chichunwang/self_balance_plane/plan-a-handoff/參考文件/2026-10-27-測試紀錄與監控-design.md

# 測試紀錄與監控：設計

> **狀態：使用者 2026-10-27 同意；第一批（相機）已寫，第二批（伺服、IMU、調平）等樹莓派接好**
> 搭配 [`docs/硬體上機檢查清單.md`](硬體上機檢查清單.md)。清單是給人照著做的；這份寫「每次測試留下什麼、格式、時間怎麼對、怎麼回到筆電、要寫哪些工具」，給寫工具和寫控制程式的人看。

## 1. 為什麼要做

使用者原話（2026-10-27）：「我想要測試要有log 甚至測試相機也會錄影 這樣你就有所有測試data等同於一個回授去調整你的程式」。

所以目標是一個迴圈：實機測試 → 紀錄自動回到筆電 → 我看圖、算成績、把真實資料餵回模擬 → 改參數或程式 → 再上機。

- **要做到**
  - 每次測試（包括校正工具）自動留一個完整的資料夾，不靠人記得按錄影。
  - 相機每一張、每個控制週期、IMU、壓電片、使用者按鍵，全部在同一個時鐘上，事後對得起來。
  - 紀錄能直接餵進 `ppsim` 的估測器和控制器重播。
- **不做**：雲端、資料庫、漂亮的儀表板（第一版只有終端機一行狀態）、把全解析度影像即時傳回筆電。
- **絕對不能**：記錄或監看讓控制迴圈晚拍（比沒有紀錄還糟）；錄影加疊圖或壓太爛，事後沒辦法重新找球。

## 2. 決定

使用者決定的：
1. 控制用樹莓派 4（4GB）優先（2026-10-27：「teensy這個先不做 還是以rpi4 4gb優先」）。之後在 Teensy 那個對話同意 README、BOM 兩套都寫完整、檔頭註明樹莓派優先；這份設計照樹莓派寫，換 Teensy 時時鐘那節要改（要跟 Teensy 對時）。
2. 測試資料用 SSH 從筆電拉回（2026-10-27：「可以」）。
3. 其他都照我的建議（2026-10-27：「都照建議 你跟我說怎麼做就行」）。下面這些是**我的預設**，使用者看到不對可以推翻：

| # | 預設 | 理由 |
|---|---|---|
| a | 伺服訊號用 PCA9685（BOM 方案 B），I²C 跟 IMU 共用，400 kHz | 波形由硬體產生，不受 Linux 排程影響；樹莓派自己的硬體 PWM 只有兩路 |
| b | 正面＝1 號伺服那側（+y） | BOM 第 0 節第 8 點本來就這樣定；盪鞦韆相機架的腳在左右 |
| c | 樹莓派存 `~/pp/runs/`，筆電存專案的 `out/real/` | 輸出留在專案裡；C 槽還有約 64 GB，替代相機每分鐘約 50–80 MB（要實測） |
| d | 錄影每一張都存、灰階 JPEG 一張接一張存成一個檔、不疊圖 | 程式當掉也不會壞檔；事後可以重新找球；疊圖影片在筆電上另外做 |
| e | 監看第一版：SSH 終端機每 0.5 秒一行狀態＋跑完印摘要；即時視窗等第一輪實測後再決定要不要做 | 樹莓派 4 的 CPU 留給控制和找球 |
| f | 手機側拍是選配，用 GPIO27 的 LED 對時 | LED 同時拍得進俯視相機和手機，順便量相機延遲 |
| g | IMU 零點用手機水平儀「原地轉 180°」量平台的真實傾斜當基準 | 理由在清單第 6 階段開頭 |
| h | 程式放新的頂層資料夾 `ppreal/`（跟 `ppsim/` 並列），樹莓派的 `~/pp/` 是同一份的副本 | 實機的東西集中一處，模擬那邊不動 |

## 3. 時鐘

- **樹莓派上全部用 `CLOCK_MONOTONIC`**，Python 裡就是 `time.monotonic_ns()`。下面兩個也是這個時鐘（2026-10-27 查原始碼確認），所以**不用對時**，直接比：
  - 相機：OpenCV 要明講用 V4L2 後端（`cv2.VideoCapture(0, cv2.CAP_V4L2)`），`CAP_PROP_POS_MSEC` 就是 V4L2 buffer 的時間戳。uvcvideo 預設在「主機收到這一張的第一個 USB 封包」時打點，**不是曝光的時刻**；曝光到打點差多少要用 LED 量（清單 7-8）。
  - 壓電片：Trixie 的 `python3-libgpiod` 是 v2，`EdgeEvent.timestamp_ns` 預設是 MONOTONIC。**不要設 `debounce_period`**：設了以後時間戳會晚一整段去彈跳時間；連跳在程式裡照時間戳濾掉。
  - IMU 沒有自己的時間戳，記讀完當下的 `monotonic_ns()`。
- 筆電上（明天先用筆電測替代相機）用 `time.perf_counter_ns()`；Windows 的 DSHOW 不給每張的時間戳，只記「讀到的時刻」。
- 每一列都記整數 `t_ns`（絕對值）。`meta.json` 記這次的 `t0_ns` 和開始的牆上時間，分析時換成「開始後幾秒」。
- 跟手機側拍對時：開始和結束時 LED 閃 3 下（短短長），事件檔記每一下的時間；俯視相機的畫面裡也拍得到 LED，順便量相機延遲。

## 4. 一次測試＝一個資料夾

名稱 `<流水號>_YYYYMMDD-HHMMSS_<種類>`，例如 `0007_20261028-153012_balance`。樹莓派 4 沒有電池時鐘，比賽現場沒網路時牆上時間可能不對，排序和認資料夾靠流水號（存在 `~/pp/runs/.seq`）；`pp run` 開跑前如果連得到筆電，就順便把時間對過去。
種類：`balance`、`push`、`servo`、`imu`、`level`、`cam`、`motion`……校正工具跑的時候也開資料夾。

| 檔案 | 誰寫 | 多久一筆 | 格式 |
|---|---|---|---|
| `meta.json` | 啟動程式 | 開始、結束各寫一次 | JSON |
| `events_<程式>.csv` | 各程式各寫一個（`launcher`／`ctrl`／`vision`） | 有事才寫 | CSV，拉回時照 `t_ns` 合併成 `events.csv` |
| `control.bin` | 啟動程式（資料來自控制程式） | 每個控制週期 | 二進位（numpy 結構陣列，欄位寫在 meta） |
| `imu.bin` | 啟動程式（資料來自控制程式） | 每讀一次 IMU | 二進位 |
| `camera.csv` | 找球程式的錄影執行緒 | 每一張 | CSV |
| `cam.mjpeg` | 找球程式的錄影執行緒 | 每一張 | JPEG 一張接一張 |
| `piezo.csv` | 啟動程式（資料來自控制程式） | 每次觸發（期末） | CSV |
| `system.csv` | 啟動程式 | 每秒 | CSV |
| `console.log` | 啟動程式 | — | 終端機印出的全部文字 |

**控制程式完全不碰檔案。** 每拍把一列寫進共享記憶體的環形緩衝（筆電實測填一列 2–4 µs，樹莓派 4 估計 10–20 µs，不到一拍的 1%），由啟動程式（它本來就要讀共享記憶體印狀態行）每 0.2 秒收一次、寫檔。理由：
- 寫檔平常只要幾十 µs，但 ext4 提交日誌、或同一張記憶卡上錄影寫太多被節流時，會卡幾十到幾百 ms，控制迴圈不能等。
- 也不能在控制程式裡開執行緒排版 CSV：Python 的 GIL 每 5 ms 才換手，會讓控制迴圈晚拍（README「硬體接法」在筆電上實測過）。
- 找球程式的錄影執行緒寫檔沒關係：寫檔時會放開 GIL，卡住的只有那條執行緒，主執行緒照樣讀相機、找球；來不及就跳過那張不存。

當掉或斷電掉多少：控制程式當掉只掉環形緩衝裡還沒收的（≤ 0.2 秒）；啟動程式每 5 秒 `fsync` 一次，樹莓派突然斷電最多掉最後 5 秒（不 fsync 的話 Linux 預設約 30 秒才寫回記憶卡）。二進位轉 CSV 時，檔尾不滿一列的半截丟掉。

### 4.1 `meta.json`
- `run_id`、`kind`、`note`（開始時打的備註）、`result`（跑完問「結果？」打的那句）、`status`（`running`／`done`／`crashed`：開始就寫 `running`，正常結束才改）
- `wall_start`、`wall_end`、`t0_ns`、`t_end_ns`、`clock`（`CLOCK_MONOTONIC` 或 `perf_counter`）、`host`
- `code`：`ppsim/`、`ppreal/` 每個 `.py` 的雜湊和合起來的短碼（專案不是 git，用這個認版本）
- `params`：這次用的 `ppsim.params.Config` 全部值（含改過的）
- `calib`：當時 `calib.json` 的完整內容
- `camera`：要求的和讀回的設定（寬高、格式、曝光）、實際每秒張數
- `dtypes`：`control.bin`、`imu.bin` 的欄位和型別；`mode_codes`：模式代碼對照
- `summary`：結束時算的成績（見第 6 節的摘要）
- `versions`：Python、numpy、OpenCV 版本

### 4.2 `control.bin`（每個控制週期一列，約 104 bytes）
| 欄位 | 型別 | 說明 |
|---|---|---|
| `t_ns` | int64 | 這一拍開始的時刻 |
| `tick` | uint32 | 第幾拍 |
| `dt_us` | float32 | 跟上一拍開始差多久（看有沒有晚拍） |
| `busy_us` | float32 | 這一拍算了多久 |
| `mode` | uint8 | 控制器模式（代碼寫在 meta） |
| `est_ok` | uint8 | 估測器有沒有鎖定球 |
| `meas_age_ms` | float32 | 用到的最新一張相機量測離拍攝多久 |
| `est_x/y/z` | float32×3 | 估測的球位置（mm，平台座標） |
| `est_vx/vy/vz` | float32×3 | 估測的球速度（mm/s） |
| `tau_x/y` | float32×2 | 控制器要的傾斜（`ppsim` 的定義：指向下坡、tan 值） |
| `heave_mm` | float32 | 要的升降 |
| `trim_x/y` | float32×2 | 自動水平校正目前的修正量 |
| `th1/2/3` | float32×3 | 三顆伺服角命令（度，臂往上＝正） |
| `us1/2/3` | float32×3 | 實際送出的脈寬（µs） |
| `imu_fb/lr` | float32×2 | 最新 IMU 傾斜（度，前面高／右邊高為正；這拍沒讀就 NaN） |
| `flags` | uint16 | 晚拍、球不見、I²C 錯誤等旗標 |

### 4.3 `camera.csv`（每張一列）
`frame`、`t_cap_ns`（V4L2 時間戳；筆電上空白）、`t_read_ns`（讀到的時刻）、`t_done_ns`（找完球的時刻）、`found`、`u_px`、`v_px`、`r_px`（球心和半徑）、`x_mm`、`y_mm`（換到平台座標）、`area_px`、`rec`（有沒有存進影片；錄影來不及時會跳過，記 0）、`jpg_off`、`jpg_len`（這張在 `cam.mjpeg` 的位置）。

### 4.4 `imu.bin`
`t_ns`、`ax`、`ay`、`az`、`temp`、`gx`、`gy`、`gz`（MPU-6050 原始 int16，之後換校正值可以重算）、`err`（這次讀取有沒有 I²C 錯誤）。

### 4.5 `events_<程式>.csv`（拉回後合併成 `events.csv`）
`t_ns`、`src`（`ctrl`／`vision`／`launcher`／`tool`）、`kind`、`detail`。控制程式的事件也是放進共享記憶體、由啟動程式寫。
`kind`：`start`、`stop`、`mark`（使用者按空白鍵＝「我推了」；按 `m` 可以打一句話）、`mode`（模式切換）、`warn`、`error`、`led`、`calib`（校正工具改了哪個值，從多少改成多少）。

### 4.6 `system.csv`（每秒一列）
`t_ns`、`cpu_temp_c`、`throttled`（`vcgencmd get_throttled` 的值）、`arm_mhz`、`load1`、`ctrl_cpu_pct`、`vision_cpu_pct`、`mem_avail_mb`、`disk_free_mb`、`log_dropped`（排不進佇列丟掉幾筆）。

## 5. 錄影

- 找球程式讀到的每一張都存：主執行緒讀相機、找球、把結果交給控制程式；另一條執行緒做 JPEG 壓縮和寫檔（OpenCV 的壓縮會放開 GIL）。佇列滿了就跳過那張不存（`rec`＝0、計數），**絕不讓找球等錄影**。
- 替代相機給 YUYV：`CAP_PROP_CONVERT_RGB` 設 false，OpenCV 回傳 480×640×2 的原始 YUYV，第 0 層就是灰階（不用轉彩色），JPEG 品質 90。OV9281 本來就給 MJPEG：同樣設定下 OpenCV 回傳 1×N 的 JPEG 位元組（查過 `cap_v4l.cpp`），直接存、不重壓，找球時再 `cv2.imdecode`。
- `cam.mjpeg` 就是 JPEG 一張接一張，當掉也不會整檔壞掉；`camera.csv` 有每張的位置。
- 不疊圖。筆電上 `pp report` 另外做 `overlay.mp4`：畫上找到的球（圈）、估測位置（點）、平台傾斜（箭頭）、時間和模式。
- 大小（要實測）：替代相機灰階 640×480 每張約 25–45 KB，每分鐘約 50–80 MB。OV9281 每秒 120 張時：640×480 約大 4 倍、1280×720 約大 12 倍，到時候再看要不要降存檔張數或改存 D 槽。
- `.mjpeg` 用 VLC 或 ffplay 播得出來，Windows 內建播放器不行；平常看 `pp report` 轉出的 mp4。

## 6. 即時監看

第一版（樹莓派 4 的 CPU 留給控制和找球）：

- 使用者在筆電的 PowerShell 用 SSH 開 `pp run ...`，終端機每 0.5 秒更新一行：
  ```
  12.4s 平衡  球(+3.1,-0.8)mm  傾斜 前+0.4° 右-0.1°  迴圈 p99 2.1ms 晚0  相機 30.0/s 掉0  62°C
  ```
- 按鍵：空白鍵＝記「我推了」、`m`＝打一句備註、`q`＝停。
- 每次按空白鍵（推球）後，狀態行下面多印一行：這次推完球的最大速度（cm/s）、滾最遠離中心多遠、幾秒回到 1 cm 內。使用者才知道自己推多大力（清單第 9 階段有模擬給的期待值）。
- 跑完馬上印摘要：撐了幾秒、有沒有掉、穩住後球離中心的 RMS 和最遠、每次推的速度和回來的秒數、迴圈最慢幾 ms、晚了幾拍、相機掉幾張、最高溫度；然後問「結果？」。
- 這一行和摘要由**啟動程式**印（另一個程式），控制程式只是每拍把幾個數字寫進共享記憶體，不印東西。
- 第一次連上時確認中文在 PowerShell 不是亂碼；是的話狀態行改用英文縮寫（`--ascii`）。
- 斷線和停止：
  - `pp run` 包在 `tmux` 裡跑，Wi-Fi 斷了 SSH 掉線也不會被砍；啟動程式也不理 SIGHUP。
  - 按 `q`：平台 1 秒內慢慢回中位、停住，再收尾寫檔。
  - 控制程式當掉：PCA9685 會一直送最後一個脈寬（平台停在最後的姿勢）。啟動程式發現它死了，就自己接手 I²C，1 秒內慢慢回中位。

第二版（第一輪實測後再決定）：啟動程式用 UDP 把狀態（每秒 20 次）和縮小的畫面（每秒 5 張、320×240）丟給筆電，筆電開一個視窗看球、軌跡、曲線。UDP 送不出去就丟掉，不會卡樹莓派。

## 7. 傳回筆電、存放、清理

- `pp pull`（筆電）：SSH 列出 `~/pp/runs/`，把還沒拉過的資料夾拉到 `out/real/`（Windows 內建的 `scp`，或 `ssh … tar | tar`），二進位轉 CSV，檢查張數和大小對得上，再在樹莓派那份放一個 `.pulled` 記號。測完我自己跑，不用使用者動手。
- `pp deploy`（筆電）：把 `ppsim/`、`ppreal/` 複製到樹莓派的 `~/pp/`，記下程式版本短碼。
- 樹莓派上**不自動刪**。記憶卡剩不到 4 GB 時 `pp preflight` 會警告、不到 1 GB 不讓跑；要清就跑 `pp clean`，只刪已經拉回筆電的，而且先問使用者。
- 筆電上全部留著。`out/real/` 超過 20 GB 時跟使用者說。

## 8. 分析（筆電，我用）

- `pp report <run>`：時間曲線（球位置、傾斜命令對 IMU 量到的、三顆脈寬、迴圈時間、相機間隔）、俯視軌跡、成績、`overlay.mp4`、`summary.md`。
- `pp replay <run>`：把紀錄裡的相機量測（和壓電片時間）照原本的時間餵進 `ppsim` 的 Estimator＋Controller，先確認重播出來的命令跟實機一樣；再改參數（例如 `--set control.bal_wn=2.5`）看會怎樣。
- 之後再做：跟模擬並排（同樣的起點、同樣的推球時刻）、從實測反推參數（相機延遲、伺服反應、球滾動的係數、平台不平的地方），回填 `ppsim/params.py` 重跑模擬。
- 球當水平儀：平衡穩住、球停在中心不滾時，平台就是真的水平（對球來說）。`pp report` 每次都取那段時間的 IMU 平均，跟校正檔的零點比，差超過 0.1° 就提醒。以後就不用再拿手機校 IMU。

## 9. 校正檔 `~/pp/calib.json`

工具寫、控制程式讀；每次測試抄一份進 `meta.json`。每次修改在 `history` 加一筆，也在當次的事件檔（`events_tool.csv`）記一筆 `calib`。

```json
{
  "version": 1,
  "updated": "2026-10-28T15:30:12+08:00",
  "pca9685": {"address": 64, "osc_hz": 25000000, "osc_measured": false, "prescale": 19, "freq_hz": 305.2},
  "servo": [
    {"leg": 1, "channel": 0, "dir": 1, "center_us": 1508.0, "center_us_jig": 1506.0,
     "us_per_deg_up": 11.2, "us_per_deg_down": 11.0},
    {"leg": 2, "channel": 1, "...": "..."},
    {"leg": 3, "channel": 2, "...": "..."}
  ],
  "imu": {"bus": 1, "address": 104, "mount": "左前 150°",
          "axis_map": [[0, -1, 0], [1, 0, 0], [0, 0, 1]],
          "zero_g": [0.012, -0.031, 0.0], "temp_c_at_zero": 31.5},
  "camera": {"device": "USB2.0 PC CAMERA", "width": 640, "height": 480,
             "map": {"u0": 321.5, "v0": 238.0, "mm_per_px": 0.81, "front_deg": 90.0, "mirror": false},
             "platform_r_px": 122.2},
  "table": {"tilt_fb_deg": null, "tilt_lr_deg": null},
  "history": [{"time": "2026-10-28T15:30:12+08:00", "what": "center_us leg1 1506 → 1508（level auto）"}]
}
```

- `pca9685`：清單 1-6 量完，`osc_hz` 換成實測的振盪器頻率、`osc_measured` 改 true，再重選 `prescale` 讓 `freq_hz` 接近 300。µs 換算都用 `osc_hz`。
- `camera.map`：`ppreal.calib.CamMap`（像素 → 平台 mm）；`u0`、`v0` 是平台圓心、`mm_per_px` 用平台半徑 99 mm 算、`front_deg` 是 +y 在畫面裡的方向（90°＝畫面上方）、`mirror` 是畫面有沒有左右翻。`platform_r_px` 拿來畫找球的範圍、算球該多大。`cam calib` 寫、`cam calib --check` 只更新圓心和比例（2026-10-27 第一批實作的格式；之後要加 `lens_height_mm` 修正視差，球心高出板面 2 cm，現在的 mm 會大約 5%）。
- `axis_map`：平台座標（x 右、y 前、z 上）＝ `axis_map` × IMU 讀值，每列只有一個 ±1。
- `zero_g`：平台座標（`axis_map` 轉過之後）的零點，單位 g；`imu` 另外記 `who_am_i`（晶片型號，決定溫度怎麼算）。
- `center_us`：目前用的中位（調平後）；`center_us_jig`：3-3 用治具量的，留著對照。
- 角度換脈寬：`us = center_us + dir × 角度 × us_per_deg`（角度 > 0 用 `up`、< 0 用 `down`）。

## 10. 樹莓派上的程式分工（給寫控制程式的人）

| 程式 | 做什麼 | 寫哪些檔 |
|---|---|---|
| 啟動程式 `pp run` | 開資料夾、寫 meta、開下面兩個程式、讀鍵盤、印狀態行和摘要、每秒記系統狀態；從共享記憶體收控制程式的紀錄寫檔；控制程式死掉時接手讓平台回中位 | `meta.json`、`events_launcher.csv`、`events_ctrl.csv`、`control.bin`、`imu.bin`、`piezo.csv`、`system.csv`、`console.log` |
| 找球程式 | 讀相機、找球、最新量測放共享記憶體；錄影執行緒寫檔 | `camera.csv`、`cam.mjpeg`、`events_vision.csv` |
| 控制程式 | 固定頻率迴圈：讀最新量測和壓電片事件 → `ppsim` 的估測器、控制器 → 逆運動學 → PCA9685；讀 IMU；每拍一列寫進共享記憶體 | 不寫檔 |

- 控制程式自己一個程式（README「硬體接法」在筆電上量過：同一個程式開執行緒會搶 GIL）。樹莓派 4 上能跑幾 Hz 要實測（README 方案 B：熱點可能要改 numba／C++、控制降到 250 Hz）。
- 等下一拍的方法要在樹莓派上重量，不能直接搬筆電的結論（README 那組是 Windows 量的）：
  - 用 `chrt`（SCHED_FIFO）又一直空轉吃滿一顆核心的話，Linux 會強制它每秒停約 50 ms（`sched_rt_runtime_us` 預設 950000），新核心改成讓餓到的一般程式插隊，一樣會晚拍。要用 `chrt` 就「睡到下一拍前約 0.2 ms 再空轉」。
  - 只用 `nice` 的話，同一顆核心上的其他程式還是會切進來。
  - 可以考慮 `cmdline.txt` 加 `isolcpus=3`，把一顆核心整個留給控制程式，再用 `os.sched_setaffinity` 綁上去。
  - 量法：同一份迴圈跑 sleep、空轉、睡到前 0.2 ms 再空轉三種，各 1 分鐘，看晚超過 1 ms 的拍數和最壞值。
- I²C 時間要算進每一拍：讀 IMU 14 bytes 約 0.4–0.5 ms，三路脈寬一次寫完約 0.3 ms（要先開 MODE1 的自動遞增）。控制 500 Hz 時一拍只有 2 ms，IMU 可以每 4 拍讀一次（125 Hz）。
- I²C 同時只給一個程式用：單次傳輸 Linux 會排隊，但 PCA9685 改頻率要「睡眠 → 寫 PRE_SCALE → 叫醒 → 等 500 µs」好幾次傳輸，兩個程式一起做會互相打斷。用鎖檔（`flock /run/lock/pp-i2c.lock`），程式死掉鎖會自動放開，啟動程式才接得手。測試時 I²C 歸控制程式；不測試時歸校正工具。
- PCA9685、MPU-6050 上電都在睡眠，要先寫暫存器叫醒；PCA9685 的 PRE_SCALE 只能在睡眠時寫，叫醒後等 500 µs。上電時 PCA9685 每一路都是關的（伺服收不到訊號、平台趴著），所以清單要求先送收合位置、開伺服電源，再用 `pp motion unfold` 慢慢升到中位。
- 樹莓派系統：Raspberry Pi OS Lite 64 位元（2026-10 是 Debian 13 Trixie、Python 3.13）。apt 裝 `python3-numpy`（2.2）、`python3-opencv`（4.10）、`python3-libgpiod`（v2）；`~/pp/.venv` 用 `--system-site-packages` 開（系統 Python 直接 pip 會被 PEP 668 擋），pip 只補 `smbus2`。筆電是 OpenCV 5.0、樹莓派是 4.10，程式兩邊都要能跑；每次測試記 `cv2.__version__`、`cv2.__file__`、相機後端名稱。
- 第一版的控制程式還沒有人寫（Teensy 那個對話暫停了）。

## 11. 要寫的工具（等使用者點頭才寫）

**第一批（2026-10-27 寫好，67 個測試；還沒接真的相機試過）**：計畫 `docs/superpowers/plans/2026-10-27-上機工具-第一批相機.md`
1. `ppreal/runlog.py`：開資料夾、meta、事件、CSV 的寫入（二進位的那部分跟控制程式一起做）。
2. `ppreal/camera.py`：開相機（Windows 用 DSHOW、樹莓派用 V4L2）、設定並讀回、時間戳；用編號指定時只開名字含 PC CAMERA 的那顆（`--any-camera` 才放行）。
3. `ppreal/balldetect.py`：黑色霧面平台上找白球；沒校正挑最圓的，校正後只收大小像球的。
4. `ppreal/calib.py`、`ppreal/camtool.py`：`python -m ppreal cam list | check | view | rec | fov | calib`（清單 7-0～7-7）。
5. `ppreal/report.py`：`python -m ppreal report <資料夾>`，相機那部分的成績、時間曲線、疊圖影片。
6. 審查後延到第二批的小問題和執行時的決定：記在上面那份計畫檔的最後。

**第二批（樹莓派、PCA9685、IMU 接好以後）**
6. `ppreal/pca9685.py`、`ppreal/imu.py`、`ppreal/calib.py`。
7. `pp servo …`、`pp motion …`、`pp imu …`、`pp level …`：清單第 2～6 階段。
8. `pp deploy`、`pp pull`、`pp preflight`。

**第三批（控制程式有了以後）**
9. `pp run balance` 啟動程式、狀態行、摘要。
10. `pp replay`、完整的 `pp report`。

**之後再看**：即時視窗、LED 量延遲、壓電片測試、從實測反推參數。

測試：純計算的部分（調平換算、手機反轉法、IMU 軸向、校正檔讀寫、二進位轉 CSV）寫進 `tests/test_ppreal_*.py`，在筆電跑。碰硬體的部分在清單裡實機驗。

## 12. 還沒定、要實測

- 相機的時間戳打在「收到第一個封包」，離曝光多久要用 LED 量（清單 7-8）；量到的值加進模擬的 `camera.latency`。
- 樹莓派 4 上 JPEG 壓縮每張幾 ms、記憶卡寫入夠不夠快（第二批量）。
- 控制程式在樹莓派 4 上跑得到幾 Hz（寫控制程式的人量）。
- PCA9685 內部振盪器每顆差到約 ±8%：用 GPIO22 量實際頻率（清單 1-6），振盪器值存進校正檔，換板子要重量。
- 誰寫樹莓派的控制程式。

## 13. 模擬：替代相機夠不夠期中（2026-10-27）

純 Python 模擬，照 `tests/test_control.py` 的手推測試：球停在中心，t＝2 s 時變成貼著板面滾 v（8 個方向），換 3 組亂數；替代相機設成 640×480、每秒 30 張、水平 55°、鏡頭在板面上方 45 cm、球心雜訊 0.3 px、半徑雜訊 0.5 px，其他用預設（平衡傾角上限 8°）。檢查員另外寫程式重跑過（360 次）。

| 推的速度 | 延遲 40 ms | 60 ms | 80 ms | 100 ms |
|---|---|---|---|---|
| 0.20 m/s | 8/8 沒掉，3.5 s（只跑種子 1） | 24/24 沒掉，3.6 s 回到 1 cm 內 | 8/8，3.7 s（只跑種子 1） | 24/24 沒掉，4.9 s |
| 0.25 m/s（傾角上限 8°） | 21/24 沒掉 | 13/24（其中 10 次擦到板邊） | 0/24 | 0/24 |
| 0.25 m/s（傾角上限 12°） | 24/24 | 20/24 | 9/24（都擦邊） | 0/24 |

- 種子 1 單獨跑的時候，推 0.10、0.15 m/s 在 40–100 ms 都是 8/8，最遠 34–60 mm。
- 預設相機（OV9281 的假設：每秒 120 張、延遲 20 ms）推 0.25 m/s：8/8，2.3 s 回到 1 cm 內。
- 「3 秒內回到 1 cm 內」（官方測試的標準）替代相機每一格都沒過。
- 每秒張數和延遲都有影響：每秒 30 張、延遲 20 ms 時，推 0.30 m/s 全掉（每秒 120 張時全救回）；推 0.25 m/s 這一級延遲的影響比較大。
- 把平衡參數調軟（`bal_wn` 2.0、2.5）更糟：球滾得更遠、更容易掉。
- 掉落判定偏寬：模擬要球心超過板邊**而且**比板面低 2 cm 才算掉，球心過了約 96 mm 其實已經在擦板邊，所以 0.25 m/s 那幾格的「沒掉」偏樂觀；0.20 m/s 最遠 72–84 mm，不受影響。
- **延遲怎麼補償影響很大，要查**：模擬裡估測器拿到每張的精確拍攝時間。檢查員改成「把收到的時間當拍攝時間」（完全不補償）時，推 0.20 m/s 反而 1.9–2.2 s 就回來、3 秒標準 24/24 都過；但推 0.25 m/s 變差（60 ms 只剩 7/24）。表示估測器在每秒 30 張時往前預測 60–100 ms 可能有問題，寫控制程式時要查（不屬於這份設計）。
- 可以考慮的：替代相機時平衡傾角上限放到 12°（CAD 驗過 12° 不撞）；實際延遲用 LED 量（清單 7-8）後再決定。
