chichunwang/self_balance_plane/plan-a-handoff/參考文件/硬體上機檢查清單.md

# 硬體上機檢查清單（樹莓派 4＋PCA9685）

2026-10-27 第一版。照目前優先的樹莓派 4（4GB）＋PCA9685（BOM 的方案 B）寫。
改用 Teensy（方案 A）的話：第 0 階段的樹莓派設定、第 1 階段（接線、電壓、I²C、PCA9685 頻率）、2-1 的通道（伺服接 Teensy 的 2、3、4 腳）、開跑前的檢查和收工關機都不一樣，工具改在筆電上跑；第 3 階段以後的機構、IMU、調平、相機步驟照做。
零件怎麼裝照 `docs/bom.md` 第 5 節；這份管的是「通電以後怎麼一步一步確認、量什麼、記什麼」。
測試時錄影和 log 怎麼記、怎麼回到筆電，設計在 [`docs/2026-10-27-測試紀錄與監控-design.md`](2026-10-27-測試紀錄與監控-design.md)。

**工具進度**：相機那幾支（`cam list／check／view／rec／fov／calib`、`report`）2026-10-27 寫好了，還沒接真的相機試過；`cam latency`（7-8）和第 1–6、9 階段的伺服、IMU、調平、平衡工具還沒寫。
下面的 `pp ...` 是樹莓派上的捷徑（第二批跟著做）；在筆電上先 `cd C:/Users/user/pingpong-platform`，再把 `pp` 換成 `.venv/Scripts/python -m ppreal`，例如 `.venv/Scripts/python -m ppreal cam check`。

怎麼用：
1. 照順序做，前一階段沒過不要往下。
2. 每一步看三件事：**做什麼**、**怎樣算過**、**記什麼**。標「自動」的數字工具自己存進校正檔，你不用抄。
3. 你負責動手和看；指令可以你自己打，也可以跟我說「做到 3-3 了」，我從筆電用 SSH 幫你跑。
4. 結果怪怪的就停，跟我說第幾步、看到什麼。

---

## 名詞和編號（先看這張圖）

俯視編號圖

- **正面（前）**：1 號伺服那一側，等於模擬和 CAD 的 +y、方位角 90°。側拋只從正面或背面來；盪鞦韆相機架的兩隻腳放在左右（0°、180°）。
- **左右**：站在背面往前看，右手邊是 +x。2 號在左後、3 號在右後。
- **伺服編號**：從上面看逆時針 1、2、3（90°、210°、330°）。**1 號接 PCA9685 第 0 路、2 號接第 1 路、3 號接第 2 路。**
- **伺服角的正負**：臂往上＝正，跟模擬一樣。脈寬加大時臂往上還是往下，第 3-2 步量出來存進校正檔。
- **GY-521**：照 BOM 第 3 節雕刻（亮面朝上、圖沒鏡像）的話，平台翻過來用時它在**左前（150°）**、箭頭朝正面；雕的時候有鏡像就會在右前（30°）。在哪邊都能用，第 4-3 步記下來。
  黏座子時平台是翻過來的（亮面朝上），那時看到的框在右前；翻回來從上面看才是左前，這是正常的，不是刻錯。
- **校正檔**：樹莓派上的 `~/pp/calib.json`。伺服中位、方向、每度幾 µs、IMU 零點和軸向、相機位置都在裡面，工具會自動寫，每次測試也會把當時的值抄一份進紀錄。

---

## 第 0 階段：準備（只做一次）

### 0-1 樹莓派燒系統、跟筆電連上
- [ ] 筆電開 PowerShell，產生 SSH 金鑰（一路按 Enter，不設密碼）：`ssh-keygen -t ed25519`。
  做完 `C:\Users\user\.ssh\id_ed25519.pub` 就是公鑰。
- [ ] 下載 Raspberry Pi Imager（2026-10 是 2.0 版，一步一步問的精靈畫面）。裝置選 Raspberry Pi 4，系統選 **Raspberry Pi OS Lite (64-bit)**（沒有桌面，比較省資源），儲存裝置選你的 microSD。
  ⚠ 這張卡會被清空，裡面有要留的東西先備份。
- [ ] 接著的客製化（Customisation）照順序填：
  - Choose hostname：`pingpong`
  - Localisation：城市選 Taipei（時區會變 Asia/Taipei；清單裡沒有就手動選時區）
  - Choose username：`pi`，密碼你自己設
  - Choose Wi-Fi：跟筆電同一個，名稱和密碼你自己打
  - SSH authentication：打開 Enable SSH，選 **Use public key authentication**，按 BROWSE 選 `C:\Users\user\.ssh\id_ed25519.pub`。它**不會自己帶入**這把金鑰，一定要選。選了公鑰就不能用密碼 SSH 登入。
  - Raspberry Pi Connect：不用開
  - 有出現 Interfaces & Features 的話，把 I2C 打開（沒出現沒關係，我之後開）
- [ ] 卡插回樹莓派、接電，等 2 分鐘。筆電 PowerShell 打 `ssh pi@pingpong.local`，第一次問要不要信任就打 `yes`。
- **怎樣算過**：不用打密碼就登入。登入後跟我說「連上了」，裝套件、開 I²C、放工具都由我從筆電做。
- 連不上：`ping pingpong.local` 看有沒有回應；沒有的話到路由器後台找樹莓派的 IP，改打 `ssh pi@那個IP`。

### 0-2 電源和散熱
- [ ] 樹莓派用官方 5.1 V 3 A 電源、裝散熱片和小風扇（BOM 的 E2、E3）。之後每次測試工具都會記溫度和有沒有降頻。
- [ ] 伺服的 6 V 要能「一伸手就斷電」：DC 插頭放在手邊，或在 6 V 線上加一個開關（要能過 10 A 以上，三顆一起卡住時約 7.8 A）。**這就是緊急停止**，每次開伺服電之前手先放在它旁邊。

### 0-3 手邊要有的東西
- 三用電表、游標卡尺、紙膠帶＋簽字筆、校正治具 P7、乒乓球。
- 手機裝一個能顯示到 0.1° 的水平儀 app（iPhone 內建「測距儀」裡的水平儀只到 1°，不夠）。
- 選配：一顆 LED＋330 Ω 電阻（量相機延遲、跟手機錄影對時用）。

---

## 第 1 階段：接線、通電（伺服先不插）

接線照 BOM 第 2.2 節「方案 B 的腳位」那兩張表。期中要接的：
- 樹莓派第 1（3.3V）、3（SDA）、5（SCL）、6（GND）腳接 PCA9685；IMU 接在 PCA9685 另一頭那排同名的腳。
- 第 6 腳另外拉一條到端子台的地（共地）。第 1、6 腳都要分給好幾樣東西，用 Y 型杜邦線或在洞洞板上分出去。
- 比較器（第 11、9 腳，VCC 也從第 1 腳分）期末才接。
- 選配的對時 LED：第 13 腳（GPIO27）串 330 Ω → LED（BOM 的 E24，紅色 5 mm）→ 第 14 腳（GND）。7-8 量相機延遲、跟手機錄影對時用。

清單另外暫時用到一支腳：第 15 腳（GPIO22）接 PCA9685 第 15 路的訊號腳，只在 1-6 量頻率時接，量完拔掉。

- PCA9685 板子上的 V+、綠色電源端子不接；伺服的 6 V 從端子台直接給三顆伺服。
- PCA9685 和 IMU 的 VCC 都接 3.3 V，**不是 5 V**：板子的 I²C 上拉電阻接在 VCC 上，接 5 V 會把 5 V 送進樹莓派。
- 5 V、6 V 都不能碰到樹莓派的任何一支 GPIO。

- [ ] **1-1** 伺服電源不接負載，量電壓：5.9–6.3 V（用 5 V 的備案電源是 4.9–5.3 V）。記下：____ V
- [ ] **1-2** **全部斷電時**用三用電表蜂鳴檔量：端子台的地和樹莓派的 GND 要通。
- [ ] **1-3** 樹莓派開機後，量 PCA9685 的 VCC 腳、IMU 的 VCC 腳對 GND：都是 3.3 V。看到 5 V 馬上拔電，改接 3.3 V。
- [ ] **1-4** `i2cdetect -y 1` 要看到 `40`（PCA9685）和 `68`（IMU）。多一個 `70` 是 PCA9685 的廣播位址，正常。
- [ ] **1-5** `vcgencmd get_throttled` 是 `throttled=0x0`。最要緊的是「電壓不足」（0x1、0x10000）不能出現，出現就換樹莓派的電源或線。
- [ ] **1-6 PCA9685 實際頻率**：用一條杜邦線把 PCA9685 第 15 路的訊號腳接到樹莓派第 15 腳（GPIO22），`pp servo freq`。
  - PCA9685 內部振盪器每顆可能差到 ±8%（標稱 25 MHz，實際約 23–27 MHz），送出去的脈寬和頻率都會跟著偏。工具量 1 秒的週期，算出真正的振盪器頻率存起來（自動），之後送的 µs 就是真的 µs。
  - **怎樣算過**：工具照量到的值把頻率設在 300 Hz 附近，再量一次確認（DS3218 上限 330 Hz；控制程式算提前量也要用實際頻率）。量完拔掉這條線。
- [ ] **1-7** `pp imu raw`：工具先讀晶片型號（WHO_AM_I，MPU-6050 是 0x68；仿品或別的型號會是別的值，例如 MPU-6500 是 0x70。型號不同溫度的算法不同，工具會記下來，不是 0x68 也先不用緊張）。靜止時加速度合計在 0.88–1.12 g（規格書的零點和靈敏度誤差合起來最多約差 0.12 g）、溫度讀得到而且穩定、連讀 1000 次沒有錯誤。

---

## 第 2 階段：單顆伺服（還沒裝舵盤和臂）

- [ ] **2-1** 三顆伺服用紙膠帶標 1、2、3（機身和線頭都貼）。伺服插在**伺服延長線**上（BOM 的 E17：紅線和黑線已經剪開接到端子台），延長線的接頭再插 PCA9685：1 號插第 0 路、2 號第 1 路、3 號第 2 路，訊號線對準 PWM 那排。插拔時伺服電源要關著。
  - 伺服直接插 PCA9685 的話它沒有電（PCA9685 的 V+ 沒接），2-2 看起來會「很安靜」，其實是沒電。
- [ ] **2-2** 先跑 `pp servo hold 1500`（三路都送 1500 µs），**再**開伺服電源。三顆都停住、不抖、不嗡嗡叫。
- [ ] **2-3** `pp servo id`：工具依序讓第 0、1、2 路慢慢轉一下。你確認動的是 1、2、3 號。
- [ ] **2-4** 3.3 V 訊號夠不夠（BOM 第 2.2 節的判斷）：`pp servo sweep`
  - 每顆從 500 慢慢掃到 2500 µs 再回來，兩端都走得到。
  - 停著的時候不會每隔幾秒抽一下。
  - 三顆一起停在 1500 µs 放 5 分鐘，摸起來不燙。
  - 有一項不行：PCA9685 和伺服中間加 74AHCT125（BOM 的 E23）把訊號升到 5 V，再測一次。
- 記下：有沒有抽動、會不會燙。

---

## 第 3 階段：伺服裝進伺服座、裝臂（還沒接連桿）

對應 BOM 第 5 節第 1–5 步。三顆輪流做。

- [ ] **3-1** 送 1500 µs，裝圓舵盤和伺服臂，選最接近水平的那一齒（BOM 第 5 步）。
- [ ] **3-2 方向**：`pp servo dir 1`。工具把 1 號加 100 µs，問你臂往上還是往下，存成 `dir`（自動）。三顆應該一樣，不一樣就跟我說。
- [ ] **3-3 找中位**（校正治具 P7）：`pp servo center 1`
  - 伺服座立在桌上，治具放在肘關節正下方，一根 M3 螺絲穿過肘關節的套筒、兩端架在治具兩邊。
  - 治具和伺服座的底要在同一個平面（都放桌上）。伺服座已經扣進底板凹槽的話，治具也要放進凹槽：放在凹槽外面會高 2 mm，中位差約 28 µs。
  - 方向鍵 ↑↓ 每次 1 µs、PgUp／PgDn 每次 5 µs（↑ 永遠是臂往上），調到螺絲剛好平貼治具兩邊。
  - **最後一下要從下往上停**。三顆都這樣，齒輪的間隙才會吃在同一邊。
  - 按 Enter 存成 `center_us`（自動）。正常在 1500 ± 80 µs 內（舵臂最多差半齒 7.2°，每度約 11 µs）。
- [ ] **3-4 每度幾 µs**：**先把治具拿開**（M3 螺絲留在套筒裡當量測點；治具不拿開，臂往下時螺絲會頂到治具）。`pp servo scale 1`，工具送脈寬前會再問一次治具拿開了沒。工具讓臂停在中位 +300 µs、−300 µs，你用游標卡尺量「桌面到 M3 螺絲中心」的高度，照提示輸入。
  - 中位時是 50 mm。180° 版的 DS3218 約每度 11 µs，±300 µs 大約 ±27°，高度約 70 mm 和 30 mm。
  - 算出來接近每度 7.4 µs：買到的是 270° 版，跟我說。
- [ ] **3-5 範圍**：`pp servo range 1`。臂從 −45° 慢慢擺到 +45° 再回中位，不能碰到伺服座或桌面。
- 記下（自動）：每顆的 `dir`、`center_us`、往上和往下各每度幾 µs。

---

## 第 4 階段：裝上底板、連桿、平台

對應 BOM 第 5 節第 6–10 步。

- [ ] **4-1** 底板邊緣用簽字筆寫 1、2、3 和「前」：從上面看逆時針，1 號在「前」。照編號把伺服座扣進凹槽，**臂朝外**（BOM 第 9 步）。
- [ ] **4-2 連桿長度**：三根量同一個位置（例如肘關節套筒外緣到銅球外緣），三根差在 0.2 mm 內（球頭轉半圈＝0.2 mm）。記下：____／____／____ mm
- [ ] **4-3** 裝平台時 GY-521 座的箭頭朝 1 號（正面）。記下 GY-521 在左前還是右前：____
- [ ] **4-4 第一次帶平台通電**：先 `pp servo hold fold`（送收合位置 −60°，平台沒電時就趴在這附近）、再開伺服電源、再 `pp motion unfold`（3 秒慢慢升到中位）。直接送中位的話，三顆會全速轉 60° 把平台彈上來。
  - 手離遠一點。不能有卡住、喀喀聲；球頭的塑膠圓環不能頂到底。
- [ ] **4-5 慢動作**：`pp motion slow`
  - 先往正面抬 5°（正面邊緣大約高 9 mm），工具會問你：**正面有沒有變高？** 沒有的話停，三顆的 `dir` 可能全反了。
  - 再往右抬 5°：右邊（3 號那側）有沒有變高？
  - 然後升降 ±10 mm、往 8 個方向各傾斜 3°，每個動作 5 秒。
  - 最後全範圍：升降 ±22 mm、往 8 個方向傾斜 8°。看線有沒有被拉到、零件有沒有碰到。
- [ ] **4-6** 停在中位 5 分鐘：伺服摸起來溫的可以，燙手不行。
- [ ] **4-7 收合**：`pp motion fold`。三顆轉到 −60°，平台降到最低：板面離桌面約 13.5 cm（底板直接放桌上；BOM 寫的 14.35 cm 有算 8 mm 腳墊）。
- 記下：連桿長度、GY-521 在哪邊、有沒有卡住或碰到。

---

## 第 5 階段：IMU

- [ ] **5-1** `pp imu raw`（平台停在中位）：加速度合計在 0.88–1.12 g；陀螺儀靜止時每軸在 ±20 °/s 內（規格書的零點誤差上限，工具之後會扣掉）。
- [ ] **5-2 伺服在動時 I²C 不出錯**：`pp imu stress`。平台慢慢晃 1 分鐘、同時一直讀 IMU，錯誤 0 次。
  IMU 的線拉到平台上約 30 cm、又靠近伺服線，最容易在這裡出問題；有錯誤先把線綁離伺服線，還是有就跟我說（可以把 I²C 從 400 kHz 降回 100 kHz）。
- [ ] **5-3 軸向**：`pp imu axes`。工具讓平台往正面抬 5°、往右抬 5°（4-5 已經確認過方向是對的），看 IMU 哪個軸在變、正負號，存起來（自動）。
  工具會檢查三個軸是右手座標，不是就報錯。
- [ ] **5-4 暖機**：IMU 通電 5 分鐘以上，溫度 1 分鐘內變不到 0.5 °C，再做第 6 階段（MPU-6050 的零點會隨溫度飄）。

---

## 第 6 階段：調平

**為什麼要先校 IMU**：MPU-6050 規格書寫 X、Y 軸零點的典型誤差 ±50 mg，等於平台歪 2.9° 都可能讀成 0°；座子黏的角度也會再差一點，溫度從 0 到 70 °C 還會再飄 ±35 mg。直接拿 IMU 的讀數調平會調歪，所以先用手機量一次「平台真的歪多少」，扣掉 IMU 自己的誤差，之後就交給 IMU 自己調。

**為什麼不用「整台轉 180° 量兩次」**：IMU 黏死在平台上，整台一起轉的話 IMU 自己的誤差也跟著轉，抵消掉的只有桌面的傾斜。手機可以在平台上單獨轉，它自己的誤差才抵消得掉。

手機讀數的規矩（6-0、6-1、6-3 都一樣）：
- app 要顯示**有正負號、兩個方向分開**的數字；量的過程中不要按 app 的歸零或校正。
- 先認 app 的正負：手機平放桌上，用指尖把手機**上緣**抬一點點，看哪個數字在變、變正還是變負；再抬**右緣**看另一個數字。
- 手機殼、鏡頭凸起會讓手機放不平：拿掉殼，或墊一張平的卡片。
- 「轉 180°」要轉得正：在平台上沿前後方向貼一條紙膠帶，手機的長邊貼著它放。

### 6-0 先量桌子
- [ ] 手機平放在底板旁邊的桌面上，**上緣朝正面**，讀前後、左右；原地轉 180° 再讀一次。`pp level table` 照提示輸入，工具算出桌子往哪邊斜、斜多少，存起來（自動）。
- **怎樣算過**：兩個方向都在 1° 以內。超過就換一張比較平的桌子再量。
- 為什麼：手機和 IMU 量到的都是「平台對地心引力」的傾斜，等於「組裝誤差＋桌子斜」。不先量桌子的話，桌子斜 1° 會被當成組裝有問題，甚至去調連桿補桌子，換張平的桌子平台反而歪了。量了以後，6-1 和 6-2 判斷「組裝差太多」時，工具都會先扣掉桌子那一份。

### 6-1 用手機校 IMU 零點（第一次做；GY-521 被碰過或重黏才再做。換地方、溫度差 5 °C 以上時先做 6-3 複查，沒過再重做這步）
- [ ] `pp level imu-zero`，平台停在中位：
  1. 手機平放在平台正中間，**上緣朝正面**，等數字穩定，照提示輸入「前後」「左右」兩個數字。按 Enter 的同時工具讀一次 IMU。
  2. 手機原地轉 180°（上緣朝背面），再輸入兩個數字，工具再讀一次 IMU。
  3. 工具用兩次的平均算出平台真正歪多少、IMU 自己差多少，存起來（自動）。轉手機時不小心碰動平台也沒關係，平均會抵掉。
- **怎樣算過**：扣掉 6-0 量的桌子以後，平台的組裝誤差在 1° 以內（只靠治具中位時正常是這樣）。超過：回去看 3-3（治具有沒有放對平面）或 4-2（連桿長度）。

### 6-2 IMU 自動調平
- [ ] `pp level auto`。工具每 2 秒讀一次 IMU（取平均）→ 算前後、左右各歪多少 → 換算三顆伺服各要改幾 µs → **每次每顆最多改 3 µs** → 停 1 秒再量，一直重複。畫面一次一行（＋是臂往上），例如：

  ```
  第 5 次  前面高 0.32°  右邊低 0.08°  →  1 號 −3 µs  2 號 +2  3 號 +3
  ```

- **怎樣算過**：前後、左右都在 **0.1°** 以內就停（伺服死區 3 µs 大約就是 0.1°，再細也調不動）。停下來 30 秒後再量一次，還在 0.15° 內。
- 工具自己停下來的情況：
  - 扣掉桌子斜的那一份以後，任何一顆累積改超過 25 µs（伺服角約 2.3°，平台約 0.9–1.3°，看哪個方向）：組裝差太多，先調連桿長度（BOM 第 11 步，球頭轉半圈 0.2 mm）再重做。
  - 調了 40 次還沒進 0.1°：跟我說，可能有東西鬆了。
- 存起來（自動）：新的三個 `center_us`；3-3 用治具量的那組另外留著。
- 參考：平台前面高 0.5° 時，要讓 1 號的臂往下約 10 µs、2 號和 3 號往上各約 5 µs；右邊高 0.5° 時，3 號往下、2 號往上各約 8.5 µs（單獨一顆改 1 µs，平台歪約 0.034°）。
- 換桌子（例如比賽現場）時，開機先跑一次 `pp level auto`（約 30 秒）就好，不用重做 6-1。

### 6-3 用手機複查
- [ ] 跟 6-1 一樣量一次（上緣朝前、轉 180° 再量），前後、左右都在 0.15° 以內。
- 沒過的話，在現在已經很接近水平的狀態下重做一次 6-1（傾斜越小，手機沒對正造成的誤差越小），再跑 6-2。

### 6-4 回得來嗎
- [ ] `pp level repeat`：工具讓平台隨機傾斜到 5° 再回中位，重複 10 次，每次回來都讀 IMU。
- **怎樣算過**：10 次裡最大減最小在 0.1° 以內。超過表示齒輪間隙大或有螺絲鬆了（舵盤、球頭、肘關節），跟我說哪個方向比較散。

之後平衡跑穩了，球本身就是最準的水平儀：球停在中心不滾時，平台就是真的水平，控制程式會順便記下那時的 IMU 讀數，拿來複查零點，以後就不用再拿手機。

---

## 第 7 階段：相機（替代相機 USB2.0 PC CAMERA，只用在期中）

這顆只拿來做期中的平衡和手推：640×480、每秒 30 張。側拋、拍球等 OV9281 到了再弄。
7-0～7-3、7-7 先在筆電上做就好（明天），不用等樹莓派。下面直接寫筆電上要打的指令：先開 PowerShell，打 `cd C:/Users/user/pingpong-platform`，之後每一行都在這個資料夾打。

- [ ] **7-0 開始前**
  - 用貼紙或膠帶把**筆電內建的鏡頭蓋起來**。工具已經擋了不會開它，貼起來是多一層保險。
  - 插上替代相機，關掉 Windows 的「相機」App、Teams、瀏覽器的視訊（開著的話別的程式打不開相機）。
  - `.venv/Scripts/python -m ppreal cam list`：要看得到名字含 `PC CAMERA` 的那顆，旁邊標「預設用這顆」。
  - 工具只開名字含 PC CAMERA 的那顆；找不到就列出清單、叫你插好再試，不會改開別顆。
- [ ] **7-1 每秒幾張**：`.venv/Scripts/python -m ppreal cam check`。錄 10 秒（會跳出預覽視窗，按 q 提早停；按了沒反應的話先點一下那個視窗、輸入法切成英數），最後印出 ✔／✘。
  - 要每秒 29 張以上、沒有掉張。
  - **這顆一定要手動曝光**（2026-10-27 實測，室內白天）：自動曝光時前 2 秒是每秒 30 張，相機嫌暗把曝光拉長後掉到每秒 10–12 張；加 `--exposure -7` 是每秒 29.75 張、沒掉張（`-5` 也是 29.75）。之後的 `cam check`、`cam rec`、`cam view` 都加 `--exposure -7`。
  - 手動曝光以後畫面沒有變暗（平均亮度 138–157，跟自動時差不多），讀回的曝光值一直是 −1：這顆實際用多短的曝光還不確定（球 0.3 m/s、曝光 8 ms 會拖約 2.4 mm）。也可以加 `--settings` 打開相機的屬性視窗自己調。
  - 2026-10-27 手拿球在相機前移動（相機離球約 20 cm、球半徑 57 像素）：每秒 28.9 張，球在畫面裡時位置是連續平滑的線；球的輪廓清楚、球上的字有一點拖影。實際曝光多短，等相機架在平台上方固定高度、真的滾球時再量。
  - 偶爾一個 45–50 ms 的間隔是 Windows 讀畫面的時間抖動（這條路沒有相機時間戳），不是掉張；真的掉一張會接近 66 ms。
  - 鏡頭能轉的話，對著 50 cm 外的字轉到最清楚（用 7-2 的 `cam view` 邊看邊轉）。
- [ ] **7-2 量視角**（已經量過「52 cm」的話，確認一下當時鏡頭離牆幾公分）
  1. 相機正對牆，鏡頭前緣離牆 D（例如 50 cm）。
  2. `.venv/Scripts/python -m ppreal cam view`：只看畫面、不存檔，四邊有刻度、正中有十字。牆上橫貼一條捲尺，讀畫面左右邊緣各對到幾公分 → 寬 W；直的貼一條讀上下 → 高 H。看完按 q。
  3. `.venv/Scripts/python -m ppreal cam fov --d 50 --w 52 --h 39 --mount 45`（換成你量的數字；`--mount` 是打算架多高）：印出視角、最少要架多高，還有架在那個高度時每像素幾 mm、球幾個像素。自己算的話：水平視角＝2 × atan(W ÷ 2D)，例：D＝50、W＝52 → 55°。
- [ ] **7-3 算要架多高**：畫面短邊要涵蓋 25 cm（平台 19.8 cm，球被推到板邊也要整顆在畫面裡）。

  **鏡頭到平台上表面的高度 ≥ 25 × D ÷ H**

  例：D＝50、H＝39 → 至少 32 cm。實際再加 5–10 cm 留餘量（支架被碰歪、沒對正中心）。平台上表面離桌面約 17.7 cm。

  | 水平視角（4:3 畫面） | 鏡頭到平台面最少 |
  |---|---|
  | 30° | 62 cm |
  | 40° | 46 cm |
  | 50° | 36 cm |
  | 55° | 32 cm |
  | 60° | 29 cm |

- [ ] **7-4 架相機**：支架不要碰到底板（伺服的震動才不會傳上去）；鏡頭朝正下方、對準平台中心；**畫面的上方對準正面**（1 號那側）。架的時候開著 `cam view` 看，平台要整個在畫面裡、靠近正中十字。量鏡頭到平台面的高度，記下：____ cm
  - 這是替代相機的擺法。OV9281 到了要不要轉 90° 裝（畫面長邊朝正背面，側拋接得比較遠）還沒決定，到時候再改。
- [ ] **7-5 相機對平台**：`pp cam calib`（要看得到畫面：在筆電上做，或樹莓派接螢幕）。平台停在水平、先不放球：按 `c` 讓工具自己找平台的圓邊，找得不準就用滑鼠在平台邊緣點 3 下以上，對了按 Enter；工具算出中心和比例（198 mm 是幾個像素）。再照提示把球依序放在**中心、正面邊緣、正右邊**（從中心往右、跟正面成直角，在 1 號和 3 號之間、靠 3 號那邊；3 號本身在右後方），每次球停了按 Enter。最後存一張檢查圖（紅箭頭＝右、綠箭頭＝前），看方向對不對。
  - 兩點只看得出畫面轉了幾度；第三點是檢查畫面有沒有左右翻（有些相機會鏡像）。左右翻了沒抓到的話，左右的修正會變成反方向，平台會越晃越大。
  - 點平台邊緣時，幾個點要分散在一整圈上（擠在一起算出來的圓會不準）。
- [ ] **7-6 找球**：`pp cam view`。球放中心和前後左右靠邊 4 個位置，每個位置都一直有綠圈，畫面左上角的 `ball x … y … mm` 正負號要對（前面 y 是正、右邊 x 是正）；球不動時數字跳動在 0.5 mm 以內。平台上不要有燈的亮點反光。
- [ ] **7-7 錄影**：`.venv/Scripts/python -m ppreal cam rec 60 --note "說明這次在測什麼"`，錄 60 秒。要有 1800 張左右（差 1% 以內）、沒有掉張。跑完照它最後印的那行跑 `report`，會做出 `report/summary.md`（成績）、`timeline.png`（時間曲線）、`overlay.mp4`（球框起來的影片）。原始錄影是 `.mjpeg`，Windows 內建的播放器開不了，看 mp4 就好。
  - 筆電上錄的資料在 `out/real/` 底下，一次一個資料夾（編號＋時間＋種類）。
  - 這顆相機的 YUYV 如果跑不到每秒 30 張，改要 MJPG 格式再試。
- [ ] **7-8（選做）相機延遲**：LED 放在底板旁邊、畫面角落拍得到的地方。`pp cam latency`，工具點亮 LED 20 次，算「點亮」到「畫面看到亮」要幾 ms。記下：____ ms（之後填進模擬的 `camera.latency`）。
- [ ] **7-9 球放著不控制**：平台停在水平、球輕放中心，工具追 10 秒。一直往同一邊滾表示那邊低，記下方向。只當參考：平衡時控制器的積分會自己補一點傾斜。

---

## 第 8 階段：壓電片（期末才需要）

期中只平衡，用不到。期末要拍球時照 BOM 第 5 節第 14 步測極性、落球、誤觸發，到時候再補進這份清單。

---

## 第 9 階段：開平衡（期中目標）

要等樹莓派上的控制程式（相機找球＋估測＋控制，沿用模擬那一份），**這個還沒有人寫**。每次測試都會自動錄影、記 log。

每次開之前 `pp preflight` 自動檢查：校正檔讀得到、IMU 正常、相機每秒 29 張以上、記憶卡剩 4 GB 以上（不到 1 GB 不讓跑）、樹莓派 70 °C 以下、沒有電壓不足。**伺服電源的插頭在你手邊。**

`pp run` 建議在 `tmux` 裡跑（我會設好）：Wi-Fi 斷了 SSH 掉線，測試也不會被中斷。按 `q` 或程式出錯時，平台會在 1 秒內慢慢回到中位停住。

**替代相機能期待什麼**（純 Python 模擬，2026-10-27，每格 8 個方向、換 3 組亂數；延遲是相機拍到畫面到程式拿到，要 7-8 量）：
- 平衡 20 秒：延遲 60–100 ms 都撐得住，球放偏 3.6 cm 時 4 秒後離中心最遠 4–9 mm。
- 手推到每秒 20 cm（球大約 1 秒滾 20 cm）：**都不會掉**，最遠滾到離中心 7–8 cm，但要 3.6 秒（延遲 60 ms）到 4.9 秒（100 ms）才回到中心 1 cm 內。OV9281 只要約 2.3 秒。
- 推到每秒 25 cm：延遲 40 ms 大多救得回；60 ms 大多救不回（模擬裡沒掉的也多半擦到板邊）；80 ms 以上全掉。
- 所以期中用這顆相機時**推輕一點**；「3 秒內回來」是照 OV9281 訂的，這顆改成「不掉、5 秒內回到 1 cm 內」。

- [ ] **9-1 第一次**：球放中心，`pp run balance --note "第一次"`，跑 30 秒。平台開始來回晃、而且越晃越大：馬上按 `q`（或拔伺服電源），跟我說。
- [ ] **9-2 放偏**：球靜止放在離中心 3–4 cm，4 秒內回到中心 1 cm 內（替代相機延遲大的話可能要 5 秒）。
- [ ] **9-3 平衡 20 秒（期中第 1 項）**：連做 5 次，5 次都沒掉，穩住後在中心 1 cm 內。
- [ ] **9-4 手推（期中第 2 項）**：球在中心時往 8 個方向各輕推一次，**推的同時按空白鍵**（紀錄會記「這時候推了」）。每推一次，工具會印出這次推了每秒幾 cm、滾最遠多遠、幾秒回來，你就知道自己推多大力。
  - **怎樣算過**：不掉，而且回到中心 1 cm 內（OV9281：3 秒內；替代相機：5 秒內）。記下哪幾個方向、推多快的時候沒救回來。
- [ ] **9-5 久一點**：連續平衡 2 分鐘，看伺服和樹莓派的溫度。
- 每次跑完工具會問「結果？」，打一句話（例如「第 2 次推左邊掉了」），會存進那一次的紀錄，我看資料時會先讀它。

---

## 收工

- [ ] `pp motion fold`（平台降到最低）→ 關伺服電源 → `sudo poweroff`，等樹莓派的綠燈不閃了再拔電（直接拔可能弄壞記憶卡）。
- [ ] 跟我說「拉資料」，我把這次的紀錄拉回筆電看。

## 每天開工（5 分鐘版，第一次全部做完以後）

1. 先開樹莓派，`pp servo hold fold`（送收合位置，平台本來就趴在那裡），再開伺服電源，再 `pp motion unfold`（3 秒慢慢升到中位）。不要直接送中位，平台會被猛彈起來。
2. `pp preflight`。
3. 換過桌子或搬過：`pp level auto`（約 30 秒）。
4. `pp cam calib --check`：看相機有沒有被碰歪（歪了會自動重算平台位置）。
5. 開始測。
